kaidegit/RailGun/CMakeLists_template.txt

#${templateWarning}
set(CMAKE_SYSTEM_NAME Generic)
set(CMAKE_SYSTEM_VERSION 1)
${cmakeRequiredVersion}
# specify cross compilers and tools
set(CMAKE_C_COMPILER arm-none-eabi-gcc)
set(CMAKE_CXX_COMPILER arm-none-eabi-g++)
set(CMAKE_ASM_COMPILER  arm-none-eabi-gcc)
set(CMAKE_AR arm-none-eabi-ar)
set(CMAKE_OBJCOPY arm-none-eabi-objcopy)
set(CMAKE_OBJDUMP arm-none-eabi-objdump)
set(SIZE arm-none-eabi-size)
set(CMAKE_TRY_COMPILE_TARGET_TYPE STATIC_LIBRARY)

# project settings
project(${projectName} C CXX ASM)
set(CMAKE_CXX_STANDARD 17)
set(CMAKE_C_STANDARD 11)

#Uncomment for hardware floating point
#add_compile_definitions(ARM_MATH_CM4;ARM_MATH_MATRIX_CHECK;ARM_MATH_ROUNDING)
#add_compile_options(-mfloat-abi=hard -mfpu=fpv4-sp-d16)
#add_link_options(-mfloat-abi=hard -mfpu=fpv4-sp-d16)

#Uncomment for software floating point
#add_compile_options(-mfloat-abi=soft)

add_compile_options(-mcpu=${mcpu} -mthumb -mthumb-interwork)
add_compile_options(-ffunction-sections -fdata-sections -fno-common -fmessage-length=0)

# uncomment to mitigate c++17 absolute addresses warnings
#set(CMAKE_CXX_FLAGS "$${CMAKE_CXX_FLAGS} -Wno-register")

if ("$${CMAKE_BUILD_TYPE}" STREQUAL "Release")
    message(STATUS "Maximum optimization for speed")
    add_compile_options(-Ofast)
elseif ("$${CMAKE_BUILD_TYPE}" STREQUAL "RelWithDebInfo")
    message(STATUS "Maximum optimization for speed, debug info included")
    add_compile_options(-Ofast -g)
elseif ("$${CMAKE_BUILD_TYPE}" STREQUAL "MinSizeRel")
    message(STATUS "Maximum optimization for size")
    add_compile_options(-Os)
else ()
    message(STATUS "Minimal optimization, debug info included")
    add_compile_options(-Og -g)
endif ()

include_directories(${includes} Hardwares/MatKeyboard Hardwares/SteeringEngine Hardwares/LCD Middlewares/lvgl Middlewares)
include_directories(Middlewares/lvgl/gui_guider_generated)
include_directories(Middlewares/lvgl/gui_guider_generated/guider_customer_fonts)
include_directories(Middlewares/lvgl/gui_guider_generated/guider_fonts)
include_directories(Middlewares/lvgl/gui_guider_generated/images)

add_definitions(${defines})

file(GLOB_RECURSE SOURCES ${sources} "Hardwares/*.*" "Middlewares/*.*")

set(LINKER_SCRIPT $${CMAKE_SOURCE_DIR}/${linkerScript})

add_link_options(-Wl,-gc-sections,--print-memory-usage,-Map=$${PROJECT_BINARY_DIR}/$${PROJECT_NAME}.map)
add_link_options(-mcpu=${mcpu} -mthumb -mthumb-interwork)
add_link_options(-T $${LINKER_SCRIPT})

add_executable($${PROJECT_NAME}.elf $${SOURCES} $${LINKER_SCRIPT})

set(HEX_FILE $${PROJECT_BINARY_DIR}/$${PROJECT_NAME}.hex)
set(BIN_FILE $${PROJECT_BINARY_DIR}/$${PROJECT_NAME}.bin)

add_custom_command(TARGET $${PROJECT_NAME}.elf POST_BUILD
        COMMAND $${CMAKE_OBJCOPY} -Oihex $<TARGET_FILE:$${PROJECT_NAME}.elf> $${HEX_FILE}
        COMMAND $${CMAKE_OBJCOPY} -Obinary $<TARGET_FILE:$${PROJECT_NAME}.elf> $${BIN_FILE}
        COMMENT "Building $${HEX_FILE}
Building $${BIN_FILE}")
