kaidegit/RailGun/RailGun.ioc

Mcu.UserName=STM32F407ZETx
PA10.GPIO_Label=USB_RX
PA10.Signal=USART1_RX
PA13.Signal=SYS_JTMS-SWDIO
PA14.Signal=SYS_JTCK-SWCLK
PA15.GPIO_Label=TopSteering
PA15.Signal=S_TIM2_CH1_ETR
PA3.GPIO_Label=Charge_Control
PA3.Signal=GPIO_Output
PA8.GPIO_Label=KBD_R4
PA8.Signal=GPIO_Output
PA9.GPIO_Label=USB_TX
PA9.Signal=USART1_TX
PB10.GPIO_Label=BottomSteering
PB10.Signal=S_TIM2_CH3
PB15.GPIO_Label=LCD_BL
PB15.Signal=GPIO_Output
PB3.GPIO_Label=OMV_INT
PB3.Signal=S_TIM2_CH2
PC10.GPIO_Label=SCR_TX
PC10.Signal=USART3_TX
PC11.GPIO_Label=SCR_RX
PC11.Signal=USART3_RX
PC2.GPIO_Label=Shot_Control
PC2.Signal=GPIO_Output
PC6.GPIO_Label=OMV_TX
PC6.Signal=USART6_TX
PC7.GPIO_Label=OMV_RX
PC7.Signal=USART6_RX
PD0.Signal=FSMC_D2_DA2
PD1.Signal=FSMC_D3_DA3
PD10.Signal=FSMC_D15_DA15
PD14.Signal=FSMC_D0_DA0
PD15.Signal=FSMC_D1_DA1
PD2.GPIO_Label=KBD_R3
PD2.Signal=GPIO_Output
PD4.Signal=FSMC_NOE
PD5.Signal=FSMC_NWE
PD6.GPIO_Label=KBD_R1
PD6.Signal=GPIO_Output
PD8.Signal=FSMC_D13_DA13
PD9.Signal=FSMC_D14_DA14
PE10.Signal=FSMC_D7_DA7
PE11.Signal=FSMC_D8_DA8
PE12.Signal=FSMC_D9_DA9
PE13.Signal=FSMC_D10_DA10
PE14.Signal=FSMC_D11_DA11
PE15.Signal=FSMC_D12_DA12
PE7.Signal=FSMC_D4_DA4
PE8.Signal=FSMC_D5_DA5
PE9.Signal=FSMC_D6_DA6
PF0.GPIO_Label=KBD_C2
PF0.Signal=GPIO_Output
PF1.GPIO_Label=KBD_C1
PF1.Signal=GPIO_Output
PF10.GPIO_Label=LED1
PF10.Signal=GPIO_Output
PF12.Signal=FSMC_A6
PF2.GPIO_Label=KBD_C3
PF2.Signal=GPIO_Output
PF4.GPIO_Label=KBD_C4
PF4.Signal=GPIO_Output
PF9.GPIO_Label=LED0
PF9.Signal=GPIO_Output
PG12.Signal=FSMC_NE4
PG15.GPIO_Label=KBD_R2
PG15.Signal=GPIO_Output
PH0-OSC_IN.Signal=RCC_OSC_IN
PH1-OSC_OUT.Signal=RCC_OSC_OUT
