kaidegit/RailGun/Core/Inc/main.h

#define KBD_C2_Pin GPIO_PIN_0
#define KBD_C2_GPIO_Port GPIOF
#define KBD_C1_Pin GPIO_PIN_1
#define KBD_C1_GPIO_Port GPIOF
#define KBD_C3_Pin GPIO_PIN_2
#define KBD_C3_GPIO_Port GPIOF
#define KBD_C4_Pin GPIO_PIN_4
#define KBD_C4_GPIO_Port GPIOF
#define LED0_Pin GPIO_PIN_9
#define LED0_GPIO_Port GPIOF
#define LED1_Pin GPIO_PIN_10
#define LED1_GPIO_Port GPIOF
#define Shot_Control_Pin GPIO_PIN_2
#define Shot_Control_GPIO_Port GPIOC
#define Charge_Control_Pin GPIO_PIN_3
#define Charge_Control_GPIO_Port GPIOA
#define BottomSteering_Pin GPIO_PIN_10
#define BottomSteering_GPIO_Port GPIOB
#define LCD_BL_Pin GPIO_PIN_15
#define LCD_BL_GPIO_Port GPIOB
#define OMV_TX_Pin GPIO_PIN_6
#define OMV_TX_GPIO_Port GPIOC
#define OMV_RX_Pin GPIO_PIN_7
#define OMV_RX_GPIO_Port GPIOC
#define KBD_R4_Pin GPIO_PIN_8
#define KBD_R4_GPIO_Port GPIOA
#define USB_TX_Pin GPIO_PIN_9
#define USB_TX_GPIO_Port GPIOA
#define USB_RX_Pin GPIO_PIN_10
#define USB_RX_GPIO_Port GPIOA
#define TopSteering_Pin GPIO_PIN_15
#define TopSteering_GPIO_Port GPIOA
#define SCR_TX_Pin GPIO_PIN_10
#define SCR_TX_GPIO_Port GPIOC
#define SCR_RX_Pin GPIO_PIN_11
#define SCR_RX_GPIO_Port GPIOC
#define KBD_R3_Pin GPIO_PIN_2
#define KBD_R3_GPIO_Port GPIOD
#define KBD_R1_Pin GPIO_PIN_6
#define KBD_R1_GPIO_Port GPIOD
#define KBD_R2_Pin GPIO_PIN_15
#define KBD_R2_GPIO_Port GPIOG
#define OMV_INT_Pin GPIO_PIN_3
#define OMV_INT_GPIO_Port GPIOB
