kaidegit/RailGun/(commit log)

2021-05-18 update steering
2021-05-22 update lvgl gui
    [st_nucleo_f4.cfg]
2021-05-29 默认变更列表
