kaidegit/RailGun/images/硬件整体.png

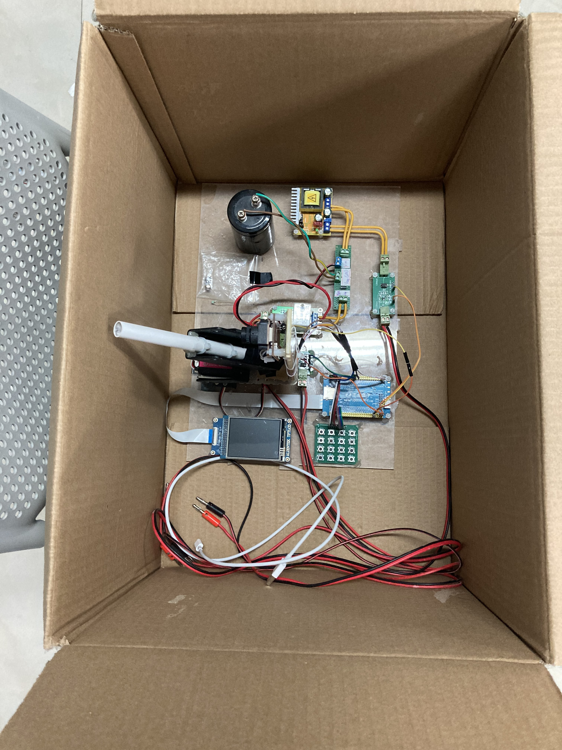
[picture p1: images/硬件整体.png]
images/硬件整体.png
